Willco9960/Drone_FCU_rev1/Drone_MCU_V1/V1_PLAN.md

# Drone MCU V1: project plan and handoff

Last updated: 2026-11-02. The saved KiCad schematic is the source of truth for the current hardware. Plans and targets below are not verified hardware or performance claims.

## Objective

Build a USB-powered tabletop prototype to develop and evaluate a neural-network flight-stabilization approach. The board reads an IMU, streams timestamped sensor data and MCU model output to a computer, and supports real-time visualization and recording. It must be straightforward to program and debug. V1 has no motor actuation and does not fly.

The long-term goal is a 3-inch-frame autonomous quadcopter that can follow, track and orbit a subject. The intended future aircraft runs stabilization, person detection, selected-subject tracking and follow/orbit decisions onboard. The laptop displays streamed camera video and lets William select a person and request a behavior; it is not intended to compute and send continuous tracking corrections. Automatic obstacle avoidance is out of scope for now. Camera and compute architecture, video and command links, latency, distance/relative-position estimation, target-loss handling, manual override and motor safety are future design work, not implemented capabilities. The preliminary design target is a direct offline laptop link up to 100 m in open conditions using its built-in radio where practical; actual range and requirements must be tested with concurrent camera video and commands, latency, packet loss and link-loss behavior. Prefer an external aircraft antenna rather than a PCB trace antenna and a compact integrated radio/MCU to reduce onboard parts and space. William likes Arduino IDE and libraries; verify real-time performance and exact library support. A Wi-Fi/BLE radio is not automatically compatible with an ExpressLRS receiver or a camera video link.

## Collaboration and project layout

- William builds the schematic and PCB himself as a learning project. Guide him in meaningful groups with clear, readable interactive wiring diagrams. Avoid drawing out the work by asking him to perform one trivial action per round. After each saved group, inspect with KiCad MCP and give precise corrections.
- Do not edit the schematic, PCB or libraries unless he explicitly requests that particular edit. Preserve open-editor/unsaved state. If explicitly editing outside KiCad, start from a fresh saved copy, inspect the entire diff and compare authoritative KiCad-exported pin-level netlists before and after; coordinate editor reload.
- The V1 files are Drone_MCU_V1.kicad_pro, Drone_MCU_V1.kicad_sch (root), MCU.kicad_sch and Sensors.kicad_sch (hierarchical sheets), Drone_MCU_V1.kicad_pcb and Drone_MCU_V1.kicad_dru (custom manufacturing checks). See AGENTS.md here for agent instructions and ../DECISIONS.md for chronological design history. References in the root AGENTS.md describe the earlier F722 project; do not apply them as V1 pin assignments.
- The earlier REV_1/Drone_FCU_rev1.kicad_sch schematic is retained as a historical/reference design. V1 is a fresh design; do not copy unresolved battery, ESC or MCU circuitry without an independent review.
- User prefers LCSC-available and reasonably priced parts and beginner-friendly footprints. Check current price/availability and manufacturer datasheets before selecting components. Use visual diagrams that are readable without overlapping text.

## Current saved state (2026-11-02)

- KiCad 10 root contains MCU and Sensors sheets. U1 is STM32H743VITx in LQFP-100. The PCB now has a provisional 38 x 38 mm rounded outline and four 3.2 mm NPTH mounting holes on a 30.5 x 30.5 mm grid; all 34 electrical footprints have a preliminary top-side placement; there are no traces and no hardware has been tested. The four MCP-created mounting footprints reference a missing library entry and must be repaired before fabrication.
- The saved KiCad-exported netlist connects U1 VDD 11/27/50/75/100, VBAT 6, VDDA 21 and VREF+ 20 to +3V3; VSS 10/26/49/74/99 and VSSA 19 to GND. VCAP 48 and 73 share a net with C10/C11 (2.2 uF each) to GND. ST AN4938 calls for connected VCAP pins and two low-ESR capacitors; actual capacitor ESR, effective capacitance, placement and regulator configuration still need selection and verification.
- J2 USB-C connects both D- contacts via U2 USBLC6 to U1 PA11 and both D+ contacts via U2 to PA12; individual 5.1 kOhm CC resistors, USB_VBUS-powered AP2112K-3.3, and input/output 1 uF capacitors are present. SWD J1 includes target +3V3, SWDIO, SWCLK, grounds 3/5/9 and NRST. BOOT0 has a 10 kOhm pulldown and a button to +3V3; NRST has a switch and 100 nF capacitor to GND. The selected AITRIP SWD probe is not verified and its 3.3 V pins are described as outputs: do not assume they are target-sense inputs or connect competing power sources.
- Sensors sheet uses U5 ICM-42631, with pins 5/8 on +3V3, 2/3/6/7/9 on GND, 10/11 intentionally open, SPI on PA5/PA6/PA7/PB0 and INT1 on PC4. R4 10 kOhm pulls chip select high; C15 100 nF, C16 2.2 uF, C17 10 nF are across the rail. Use single-interface mode and do not configure grounded pin 9 as an output. The placed symbol, footprint and 3D model now use the project-local Drone_MCU_Sensors library; the user-global library remains available. Confirm 3D model alignment in the PCB editor.
- D1 status LED with R5 is active-low on PB1; test pads expose USB_VBUS, +3V3 and GND. Every placed component has an assigned footprint; that is not a finalized BOM. SWD header is 2x5 2.54 mm, logically Cortex-numbered but not physically the standard 1.27 mm Cortex connector.
- The 2026-11-02 cleanup marked 72 unused MCU GPIO pins as no-connect for this bench revision, refreshed the capacitor and ground embedded library symbols, and removed redundant local SWD power labels. Reconnect and remove no-connect flags if any of these GPIOs are used later. KiCad CLI ERC now reports two remaining items: VCAP pins 48/73 power-output conflict (the manufacturer requires their shared connection) and the grounded IMU pin 9 bidirectional warning (use it only as an input). These are not blanket-excluded. Whole-design connected-net membership was compared before and after. The schematic is not yet ready for fabrication or a definitive JLCPCB quote.
- Remaining gates before fabrication: choose and document actual LCSC/JLCPCB part numbers and availability; validate LED polarity, all footprints and supplier assembly capability; verify VCAP and regulator capacitance/ESR including DC bias, current/thermal budget and USB source current; confirm boot option bytes/clock and USB supply for the exact MCU; verify the project-local sensor library and model in PCB/3D view; review the two remaining ERC items and calculate layout/stack-up and mounting constraints. JLCPCB-oriented routing rules assume 2-layer 1 oz FR-4, 1.6 mm thickness and green mask; the chosen order options still need confirmation. A custom rule allows only U5 pad-to-pad clearance of 0.15 mm while keeping the default at 0.20 mm. A separate targeted F.Mask check flags 14 U5 opening gaps around 0.04–0.085 mm against the 0.10 mm criterion: review and repair the footprint mask or obtain explicit assembler confirmation before fabrication. Mounting-hole library links and prior silkscreen violations were repaired on 2026-11-03; verify frame/hardware clearances and unrouted nets. See V1_BOM_REVIEW.md for the candidate BOM and unresolved assembly and power gates. Bench bring-up and USB/DFU/SWD tests have not happened.

## Planned hardware architecture

1. **MCU:** STM32H743VIT6 is the MCU used in V1 and a provisional benchmark for future flight. Its 480 MHz / 2 MB flash / up to 1 MB total RAM gives headroom over the old F722, but a specific neural model plus flight firmware must be benchmarked. William now prefers a smaller, low-cost, non-BGA MCU with integrated wireless and some AI acceleration for a future revision; this supersedes the earlier preference to retain one MCU across revisions, without changing V1. ESP32-S3 is a candidate to benchmark, not an approved replacement. Verify all H743 supply pins, regulator mode, USB supply, VCAP capacitors, BOOT0, reset and clocks for the actual LQFP100 device against the datasheet and ST AN4938. Do not assume same-package F722 pin or power compatibility.
2. **IMU:** ICM-42631 on SPI is the current V1 candidate, replacing the older ICM-42688-P. Verify library portability, pad-mask/stencil fabrication rules, firmware support and assembly sourcing. A 6-axis accelerometer/gyro can estimate roll/pitch under appropriate conditions but cannot provide absolute heading; yaw drifts.
3. **Programming and USB:** accessible SWD (PA13/PA14, target reference, ground and NRST) with an external debugger is the primary programming/recovery path. USB-C supplies the AP2112 3.3 V regulator and carries data for planned bench telemetry. The AITRIP probe and its cable/power behavior remain unverified. USB DFU is an additional target only after exact MCU boot, clock and supply verification and live testing; it is not the sole recovery method.
4. **Expansion:** reserve four motor-control-capable outputs, a receiver interface, and a separate companion/telemetry serial port for later revisions. Select pins by H743 alternate function, timer and DMA analysis. Do not imply DShot or a particular receiver protocol is already validated. Flight hardware and its pinouts are future decisions. User previously selected an AERO SELFIE 45 A 4IN1-ESC-LDO as a candidate; its connector family, mating pin numbering and cable orientation still need physical or reliable primary-source confirmation.
5. **Physical design:** aim for the future 30.5 x 30.5 mm flight-controller mounting pattern, subject to the actual frame and stack clearances. Decide V1 connector locations, board outline, layer count and assembly method before routing. Screen new parts for footprints and availability.

## Neural network, simulator and viewer

- Desktop: RTX 3080 (10 GB dedicated VRAM, 16 GB reported shared memory), i7-12700K, 32 GB RAM, Windows driver reported as 32.0.15.9174. Use as the candidate primary training/simulation machine; PyTorch CUDA is a proposed path, not installed or verified here. The M1 MacBook remains a candidate for programming, telemetry, visualization and lighter experiments.
- Proposed simulation starting point: gym-pybullet-drones + PyTorch, using a conventional PD/PID reference or reinforcement learning and a quadcopter dynamics model. Baseline sensor collection from hand motion tests sensing and noise, but does not establish motor-response dynamics or provide flight-control labels by itself. Vary model mass, inertia, motor dynamics, latency and sensor noise; reserve unseen trajectories/disturbances for evaluation.
- Train models offboard, convert/export using a toolchain confirmed compatible with the actual model and H743, then compare PC vs MCU inference numerically. Record model version, input/output units and coordinate frames, timestamp, CPU time, deadlines, RAM/flash, sample drops and telemetry throughput. User cares about training the stabilization NN, not just a visualization.
- In the viewer, one plane shows estimated measured board orientation. A second must be explicitly labeled a simulated response to the model recommendation, using a stated dynamics model and time horizon; proposed motor corrections are not themselves a physical attitude. Handle yaw drift, timestamps, coordinate frame calibration, disconnects and replay.
- Initial goals (unverified, not guaranteed): IMU sampling and inference 200 Hz, telemetry 100 Hz, viewer 30-60 Hz. Select and benchmark the actual model and adjust targets. Before any flight, validate closed-loop behavior against a conventional baseline and maintain independent arming, motor cutoff and command/link-loss behavior.
- NVIDIA Isaac Sim/Lab may be useful later for synthetic camera scenes. Isaac Sim 6.0.1 published 16 GB VRAM/RTX 4080 minimum; the user's 10 GB 3080 is below that published baseline, and shared memory is not dedicated VRAM. Do not assert that it works or cannot work without testing a specific supported configuration.

## Milestones and acceptance

1. **V1 schematic:** power, MCU, SWD/reset, USB, IMU and intentional expansion are specified and pin-checked. All selected parts and footprints are documented; hierarchy, ERC and pin-level exported netlist reviewed.
2. **V1 PCB:** frame fit, mounting, component clearances, power and return paths, IMU placement, USB routing, decoupling placement and DRC/fabrication outputs reviewed. No unsupported safety claim.
3. **Bench bring-up:** current-limited power procedure, inspect rails, confirm SWD and USB, read sensor identification and samples, check telemetry and behavior on disconnect. No ESC or propellers required.
4. **V1 training/demo:** collect/replay timestamped data, visualize measured orientation and simulated model response, evaluate a held-out simulation set, deploy and compare actual MCU inference, and report latency, sample loss and resource use.
5. **Later flight/autonomy:** separately complete and validate battery/ESC power and protection, receiver, four motors, conventional baseline stabilization, arming/failsafes, then independent simulation and controlled flight testing before adding onboard person detection and selected-subject follow/orbit. Automatic obstacle avoidance is out of scope for now.

## References

- H743 datasheet: https://www.st.com/resource/en/datasheet/stm32h743vi.pdf
- ST hardware design application note: https://www.st.com/resource/en/application_note/an4938-getting-started-with-stm32h74xig-and-stm32h75xig-mcu-hardware-development-stmicroelectronics.pdf
- ICM-42631 datasheet: https://datasheet.lcsc.com/datasheet/pdf/01f1a12efe333b71350ad9221ae6b099.pdf?productCode=C41432121
- JLCPCB manufacturing capabilities: https://jlcpcb.com/capabilities/pcb-capabilities
- STM32Cube.AI: https://stm32ai.st.com/stm32-cube-ai/
- Simulator: https://github.com/learnsyslab/gym-pybullet-drones
- Burman, Quadcopter stabilization with Neural Network (UT Austin, 2016): user-provided PDF is not included in this repository. The report trained a small model to imitate a PD controller; its conclusion states it did not deploy the NN on the microcontroller for flight validation. Do not claim the paper proves NN flight performance.

## Git hygiene

Preserve the user's existing work. Do not stage or commit live *.lck files, .history folders, local *.kicad_prl preferences, or timestamped KiCad backup archives. Never copy credentials into the repo. Keep DECISIONS.md up to date when a meaningful decision changes, including rationale and remaining constraints.

## 2026-11-03 pre-routing cleanup

- Four board-only holes use the standard `MountingHole:MountingHole_3.2mm_M3` footprint. J2 uses the project-local `Drone_MCU_Connectors` library with shell-edge silkscreen moved to fabrication layer; its pads and physical position are unchanged. Some overlapping reference labels were moved from silkscreen to F.Fab.
- KiCad CLI DRC reports 14 IMU mask-clearance violations and 105 unrouted connections; no tracks have been added. The shared-mask-opening experiment was rejected for now: it produced 80 bridge warnings and requires assembler acceptance. Do not waive these or send for manufacture without a reviewed IMU mask/stencil plan. Two schematic ERC warnings remain as described above.
- `V1_BOM_REVIEW.md` records candidate LCSC parts, VCAP and LDO analyses, and unresolved JLC assembly and thermal gates; it is not a validated order BOM.

## 2026-11-03 power and ground routing started

- Added a filled B.Cu GND zone with a notch avoiding the U5 footprint area, and GND vias/traces to C13 and C15. Added selected F.Cu traces: U3 input to C14 and EN, U3 output to C8, U1 pins 20/21, and C1–C4 power-pad chain. These are partial islands: no claim that the regulator output, MCU supplies, VCAP capacitors, USB VBUS, or all ground pads are fully connected.
- After zone refill, KiCad CLI reports 90 unconnected items and the existing 14 U5 mask-spacing violations, with no other DRC findings. Pad/net assignments and footprint identities were unchanged; only power/ground tracks and vias were added. Review decoupling placement, return paths, electrical connectivity, power/thermal budget and IMU assembly plan before fabrication. Further signal routing and refilling can change plane continuity; rerun DRC.

## 2026-11-04 main PCB routing status

The main PCB now enables four copper layers and has electrically complete outer-layer routing with inner GND zones. KiCad after refill reports zero unconnected items, zero schematic-parity issues and the 14 known U5 mask violations. This supersedes the earlier partial-two-layer status. USB coupled routing/90 ohm impedance, actual physical stackup, power widths/current budget, decoupling layout and full assembly review are still unfinished. The board remains on manufacturing hold. See reviews/2026-11-04/REVIEW.md and its final reports.
