Willco9960/Drone_FCU_rev1/Drone_MCU_V1/manufacturing/2026-11-08-quote/BOM_QUOTE_ONLY.csv

Comment | Designator | Footprint | LCSC Part # | MPN
STM32H743VITx | U1 | LQFP-100_14x14mm_P0.5mm | C114409 | STM32H743VIT6
USBLC6-2SC6 | U2 | SOT-23-6 | C7519 | USBLC6-2SC6
AP2112K-3.3 | U3 | SOT-23-5 | C51118 | AP2112K-3.3TRG1
ICM-42631 | U5 | ICM-42631_TDK_LGA14_trial | C41432121 | ICM-42631
100n | C1,C2,C3,C4,C5,C7,C8,C12,C15 | C_0805_2012Metric | C1711 | CL21B104KBCNNNC
4.7u | C6 | C_1206_3216Metric | C2167346 | C1206C475K4RACTU
1u | C9,C13,C14 | C_0805_2012Metric | C116352 | CL21B105KAFNNNE
2.2u | C10,C11 | C_1206_3216Metric | C126604 | GCM31CR71H225KA55L
2.2u | C16 | C_0805_2012Metric | C19110 | CL21B225KAFNNNE
10n | C17 | C_0805_2012Metric | C1710 | CL21B103KBANNNC
10k | R1,R4 | R_0805_2012Metric | C17414 | 0805W8F1002T5E
5k1 | R2,R3 | R_0805_2012Metric | C27834 | 0805W8F5101T5E
1k | R5 | R_0805_2012Metric | C17513 | 0805W8F1001T5E
Status | D1 | LED_0805_2012Metric | C2295 | KT-0805R
USB_C_Receptacle_USB2.0_16P | J2 | USB_C_Receptacle_HRO_TYPE-C-31-M-12 | C165948 | TYPE-C-31-M-12
SW_Push | SW1,SW2 | SW_SPST_B3U-1000P | C231329 | B3U-1000P
SWD | J1 | PinHeader_2x05_P2.54mm_Vertical | C225520 | A2541WV-2x5P
