Willco9960/Drone_FCU_rev1/Drone_MCU_V1/manufacturing/2026-11-08-quote/top_copper.png

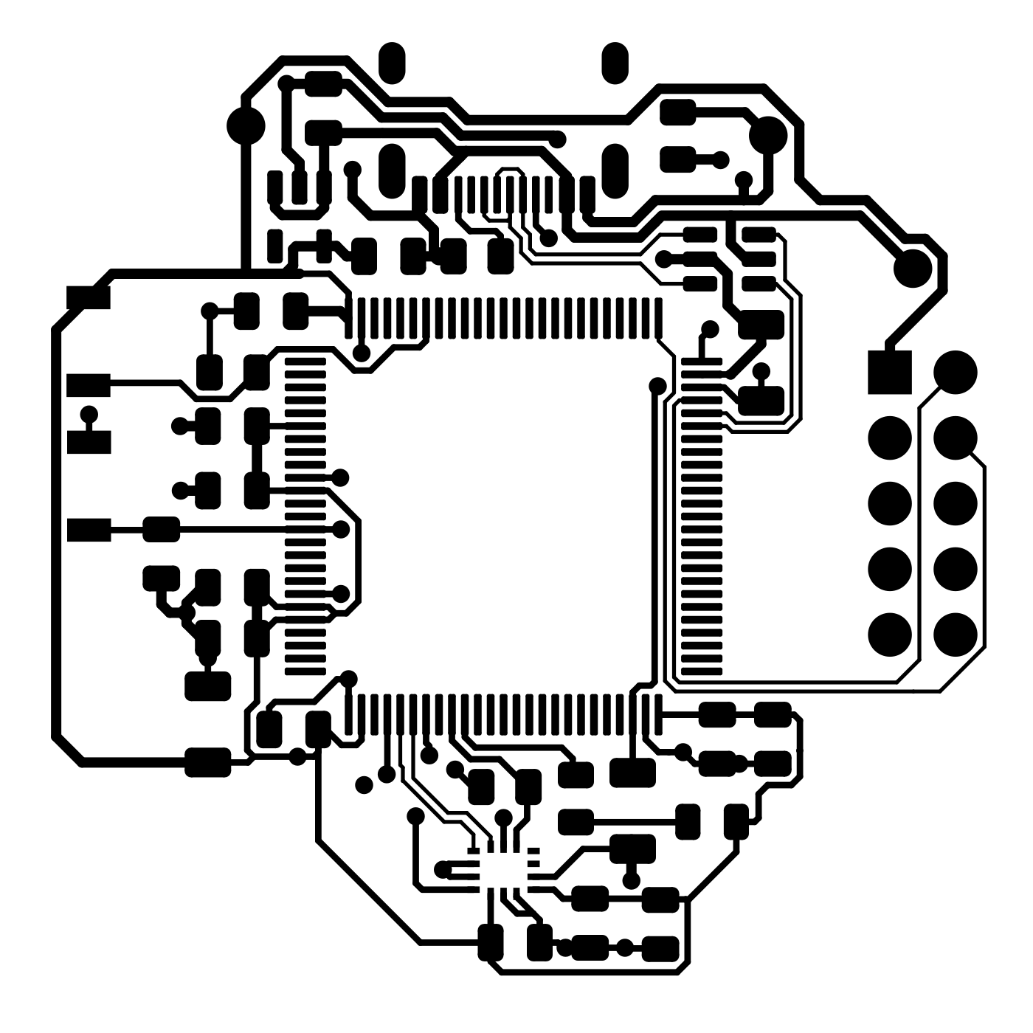
Drone_MCU_V1/manufacturing/2026-11-08-quote/top_copper.png
