Willco9960/Drone_FCU_rev1/Drone_MCU_V1/U5_REPAIR_CHECKLIST.md

# U5 repair and verification checklist

Updated 2026-11-06. V1 is a USB-powered bench prototype, not a flight controller ready to manufacture.

1. [x] Reduce U5 paste clearance by 0.01 mm per side on the placed footprint. A saved-board F.Paste Gerber showed apertures approximately 0.57 by 0.33 mm. Recheck if pad geometry changes; assembler acceptance is outstanding.
2. [ ] Establish and implement a dimensioned land and individual solder-mask design for ICM-42631. The existing pads are 0.59 by 0.35 mm on 0.5 mm pitch; separate mask polygons have insufficient gaps for the assumed 0.10 mm mask web. Manufacturer nominal package contact dimensions are 0.475 by 0.25 mm; these are component contact dimensions, not an independently validated PCB land pattern. Verify placement and assembler process before replacing them.
   - TDK AN-000262 section 2.6 recommends matching the land to the package contact and opening the mask 0.1 mm beyond it. A provisional library footprint named ICM-42631_TDK_LGA14_trial was created with 0.475 x 0.25 mm lands and 0.5 mm pitch, using x=+/-1.1625 and y=+/-0.9125 for the outer pad centers; those centers and pad numbering were checked against the ICM-42631 datasheet package drawing on page 58. The candidate lacks an explicit 0.05 mm mask expansion and final pin-1 marking, and its stencil must be recalculated. It has NOT been applied to the PCB and is NOT fabrication-ready.
   - The project library table now uses relative paths because KIPRJMOD was empty in the editor; KiCad successfully loaded the candidate. A temporary, unsaved board trial with +0.05 mm mask expansion produced 4 DRC errors (all J2 annular width), 23 warnings and 0 reported unconnected items with 2 existing exclusions; 1 schematic parity finding is expected because the schematic retains the original footprint. The trial was reverted to the last saved board. Before application, add a pin-1 indicator, confirm stencil and library settings, then resolve schematic parity and recheck connectivity and Gerbers.
3. [ ] Remove conflicting copper beneath the sensor body as recommended in TDK AN-000393, while maintaining valid ground and signal returns. Define layer-specific keepout, manually reroute affected nets and refill. Verify traces, zones and clearances on every layer. Avoid unnecessary breaks in the USB return plane.
4. [ ] Resolve KiCad DRC and review connectivity. On 2026-11-06, the PCB was updated from the schematic with footprint replacement and field updates disabled, resolving ten USB net-name parity warnings. KiCad GUI DRC after refill reports 0 parity findings and 0 reported unconnected items, with two pre-existing USB-related exclusions; 16 errors and 23 other warnings remain. Full 214-pad comparison found no net changes other than the USB name alignment. Resolve U5 pad clearance, J2 annular ring and other findings against actual manufacturing capabilities. Recheck the two exclusions; inspect mask and paste Gerbers after footprint changes.
5. [ ] Verify 3D model loading/alignment and complete assembly, power, USB, and bench bring-up review before ordering. The project-local ICM-42688-P.step file exists; a footprint dialog showed a missing-model indication, so the actual 3D viewer and project variable resolution still need testing.

Sources: ICM-42631 datasheet DS-000350 rev 1.1, section 10.2, https://datasheet.lcsc.com/datasheet/pdf/01f1a12efe333b71350ad9221ae6b099.pdf?productCode=C41432121 ; TDK AN-000393 rev 1.5, https://invensense.tdk.com/wp-content/uploads/2024/04/AN-000393-TDK-InvenSense-IMU-PCB-Design-and-MEMS-Assembly-Guidelines-v1.5.pdf .

Additional source: TDK AN-000262 rev 1.3, sections 2.5-2.6 and 3.1, https://invensense.tdk.com/wp-content/uploads/2022/07/AN-000262-TDK-IMU-Devices-PCB-Board-Design-Guidelines_v1.3.pdf .

Evidence: the current GUI DRC was run after refill and schematic parity was enabled. The report captured before the USB name alignment is in the Codex workspace as u5-live-drc.rpt; the later result was inspected in the GUI. The MCP DRC wrapper returned a report timestamped earlier than this review and must not be used as current evidence. Earlier backups and trial boards are in the Codex workspace, not fabrication deliverables.

## Update 2026-11-07

- Saved U5 library candidate with 0.475 x 0.25 mm pads, 0.05 mm mask expansion, -0.01 mm paste clearance, SMD type and a pin-1 silk marker. Applied it to the PCB and updated the U5 schematic footprint field. Recheck the marker against nearby via mask and inspect generated mask/paste Gerbers; stencil thickness and assembler approval remain open. The library name intentionally retains the trial suffix.
- GUI DRC after refill and schematic assignment: 4 errors (J2 plated-slot annular width 0.1957 mm vs 0.2000 mm rule), 21 warnings, 0 schematic parity findings and 2 excluded unconnected findings. The two exclusions correspond to the D+ and D- paths through U3 USBLC6-2SC6; the ST functional diagram shows paired I/O pins 1/6 and 3/4. Confirm pad-to-track endpoints and actual BOM part before accepting them. Source: https://www.st.com/resource/en/datasheet/usblc6-2.pdf
- MCP readback from saved board lists 14 U5 pads with the expected nets and new dimensions. Copper under U5, J2 plated slots, 3D path, silkscreen warnings and assembly/bring-up verification remain unfinished. Do not manufacture based on this update.

## U5 Gerber check 2026-11-07

KiCad MCP exported the saved board to the Codex workspace `u5-gerber-check` for inspection; these are review files, not a release package. F.Mask contains 14 U5 flashes, with 0.575 x 0.350 mm rounded-rectangle openings (rotated for the other edge) and 0.150 mm nominal same-row solder-mask webs on the 0.5 mm pitch. F.Paste contains 14 rectangular apertures of 0.455 x 0.230 mm (rotated for the other edge), about 88.1% of the 0.475 x 0.250 mm copper area. The F.Silkscreen Gerber contains the pin-1 circle. No layer geometry was altered during this check.

For a rectangular aperture, area ratio = L*W / (2*(L+W)*stencil thickness): approximately 0.764 at 0.10 mm thickness and 0.637 at 0.12 mm, before fabrication tolerances. Confirm stencil thickness, paste process and aperture acceptance with the assembler. Inspect the mask around the pin-1 mark and adjacent via in a Gerber viewer before release. This does not resolve copper beneath U5, J2 annular width, the other DRC warnings or bring-up review.

## J2 annular ring correction 2026-11-07

J2's four board-instance shield pads were enlarged from 1.00 x 1.60 mm to 1.04 x 1.64 mm for the two short slots, and from 1.00 x 2.10 mm to 1.04 x 2.14 mm for the two long slots. Original centers, GND net and 0.60 x 1.20 / 0.60 x 1.70 mm oblong holes were preserved. GUI DRC after refill reports 0 errors, 22 warnings, 0 schematic parity findings, and 2 excluded USB unconnected findings. MCP saved-board readback confirmed all four pad sizes, centers and GND assignments. The board was already modified in the editor at the start of this work; those existing edits were preserved when saving.

The project library J2 footprint has not yet been updated to match the board instance: the mismatch adds a warning, and updating the board footprint from that library could restore the old undersized rings. Synchronize the library before any footprint update, then recheck DRC. This check does not establish manufacturing readiness; U5 copper, other warnings, Gerbers, BOM, connector fit and electrical/bring-up checks remain open.

## J2 library synchronization 2026-11-07

The project-local J2 library footprint was updated in KiCad to match the four corrected board-instance shield pad sizes, without changing the pad locations or slots. The original library footprint was backed up in the Codex workspace as `J2-original-footprint.kicad_mod`. The subsequent GUI DRC displayed 0 errors and 21 warnings, down from 22 after the J2 footprint mismatch was fixed, plus two excluded USB unconnected findings. The board was saved after the refill. The full remaining warnings, excluded connections, five ignored tests and manufacturing checks still need review.

Correction to the preceding notes: the USBLC6-2SC6 is **U2**, not U3. U3 is the AP2112K-3.3 regulator. Saved-board pad readback assigns U2 pins 1/6 to USB D-, pins 3/4 to USB D+, pin 2 to GND and pin 5 to USB VBUS, consistent with the ST functional diagram. This pad-net check alone does not prove the physical track endpoints or complete USB operation; review the exclusions before release. See https://www.st.com/resource/en/datasheet/usblc6-2.pdf.

Live KiCad IPC trace queries show D- traces ending at U2 pad centers 1 and 6, and D+ traces ending at U2 pad centers 3 and 4. That supports the internal-device explanation for the two excluded findings, but is not an end-to-end USB connectivity or signal-integrity test. The same query confirms GND traces crossing under U5 and an IMU_SCK trace on the back layer passing under part of the sensor; review and manually reroute as appropriate before fabrication. Zone bounding boxes alone do not establish copper fill underneath the package.

Review-only Gerbers for four copper layers, mask, silk, board outline, and separate PTH/NPTH drill files were exported from the saved board to the Codex workspace `v1-fab-review-2026-11-07`. They are not a release package; repeat exports and inspect them after outstanding design changes. Assembly paste files and a validated assembly BOM/placement file have not been prepared.

## IMU trace reroute 2026-11-07

William rerouted the ground escapes and the IMU clock; the saved board now has 413 track segments and 30 vias. Live IPC trace query and visual inspection show the earlier ground traces crossing the U5 body and the former back-layer clock crossing have been removed. Ground escapes now head outward from the five GND pads. This is a trace inspection, not confirmation of copper-zone geometry, via clearance, or end-to-end electrical function. Refilled and saved the board. The DRC screen displayed 0 errors, 21 warnings and 2 existing excluded USB unconnected findings during the run; completion and parity status still require confirmation. Earlier exported review Gerbers predate the reroute and must be regenerated. Check the copper fills on all four layers below U5 before closing item 3.
