Willco9960/Drone_FCU_rev1/Drone_MCU_V1/Drone_MCU_V1.kicad_pcb

## KiCad design Drone_MCU_V1/Drone_MCU_V1.kicad_pcb (2026-11-09)

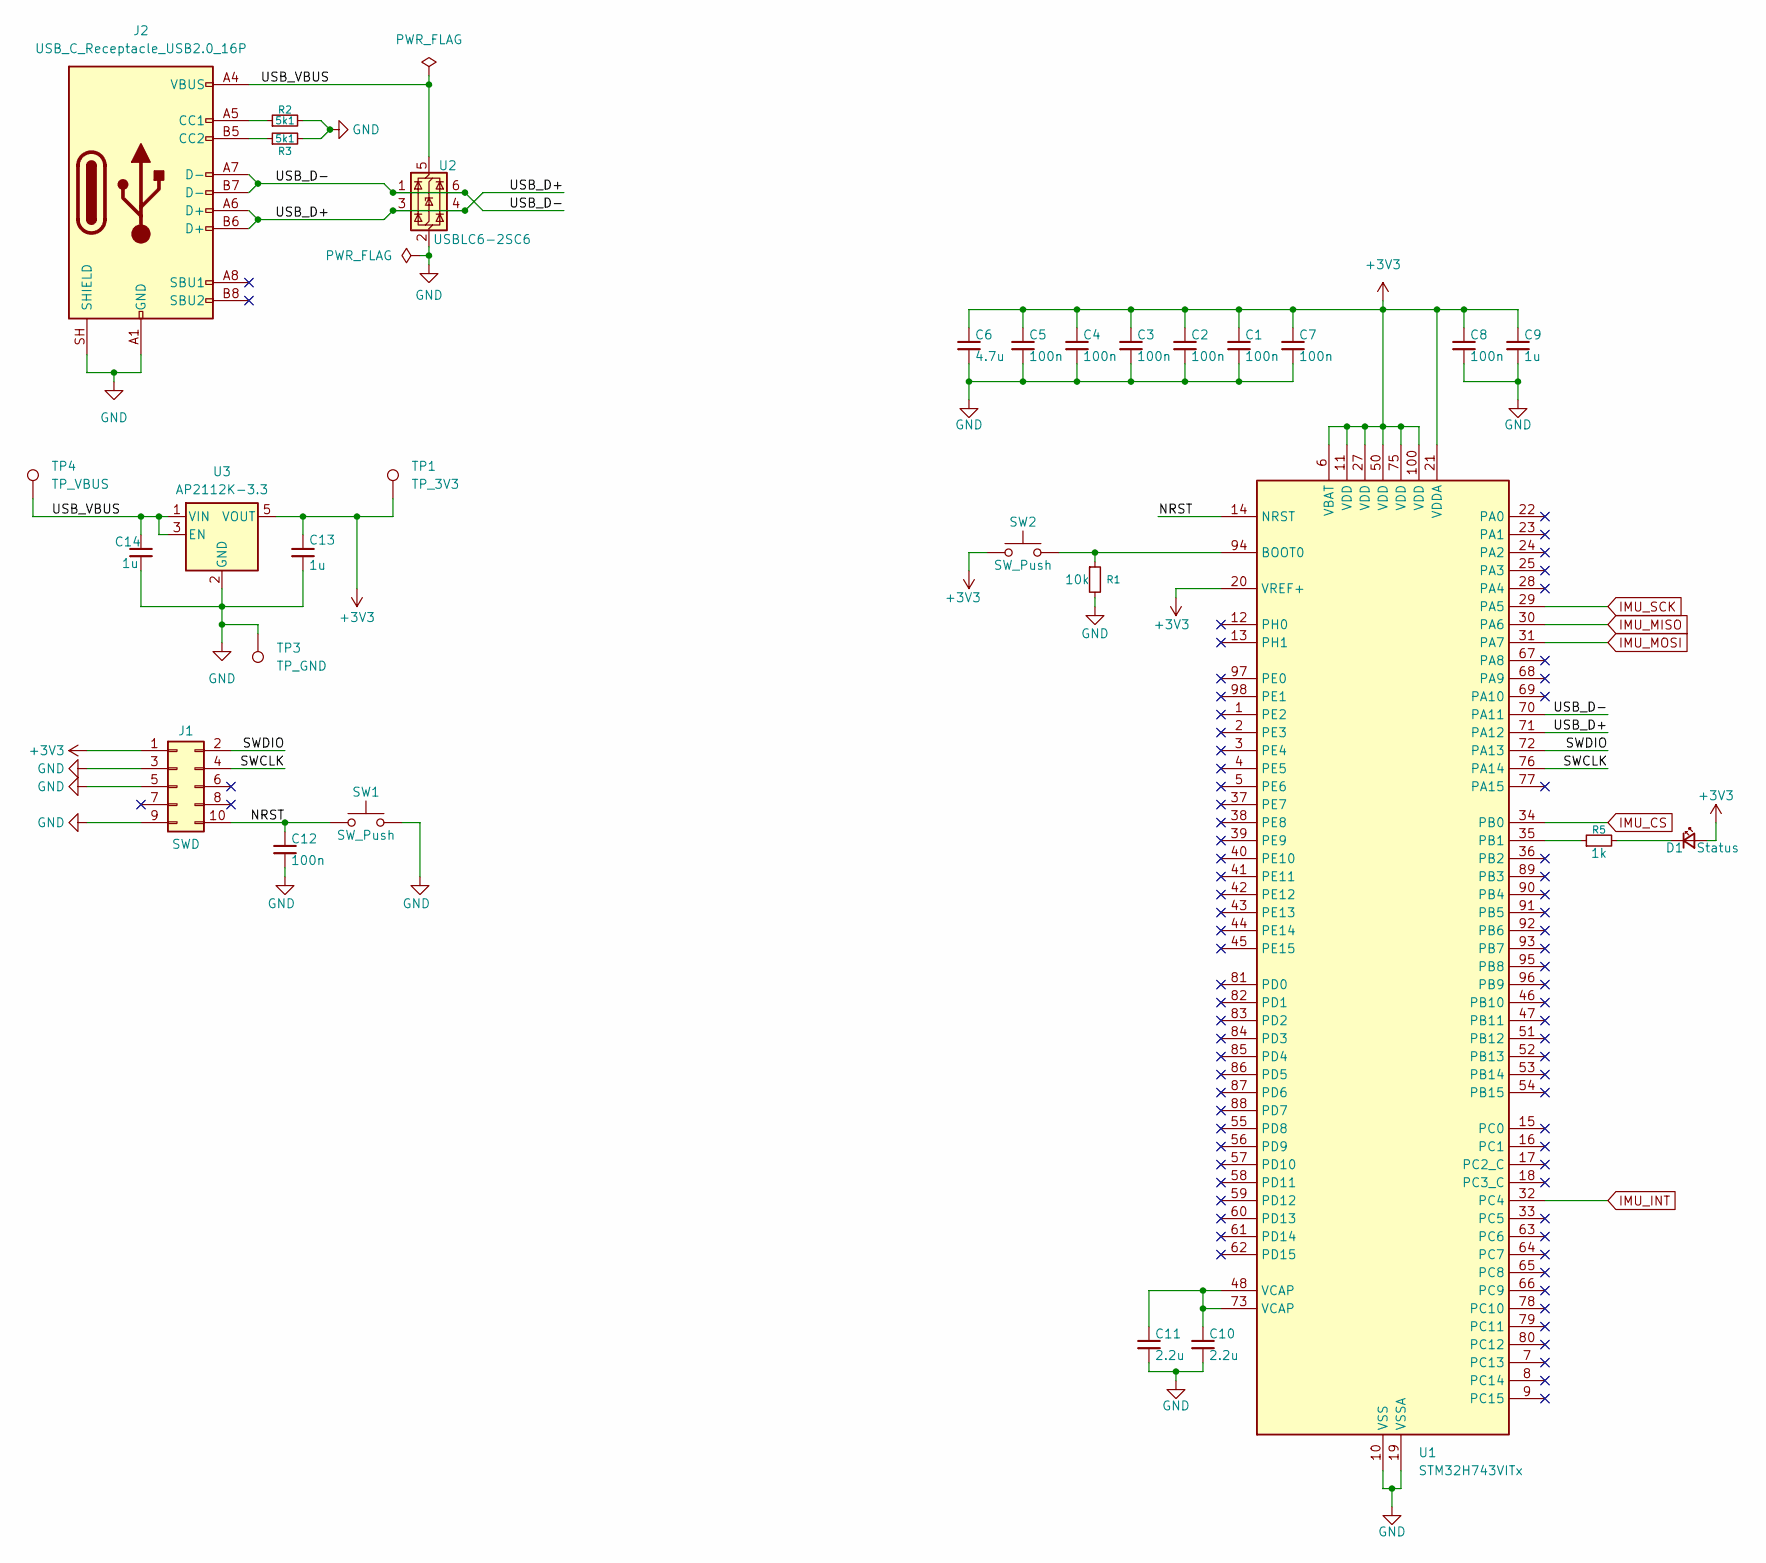
[picture p6: schematic MCU.kicad_sch]

Parts:
C1, C2, C3, C4, C5, C7, C8, C12: 100n; C_0805_2012Metric
C6: 4.7u; C_1206_3216Metric
C9, C13, C14: 1u; C_0805_2012Metric
C10, C11: 2.2u; C_1206_3216Metric
D1: Status; LED_0805_2012Metric
J1: SWD; PinHeader_2x05_P2.54mm_Vertical
J2: USB_C_Receptacle_USB2.0_16P; USB_C_Receptacle_HRO_TYPE-C-31-M-12
R1: 10k; R_0805_2012Metric
R2, R3: 5k1; R_0805_2012Metric
R5: 1k; R_0805_2012Metric
SW1, SW2: SW_Push; SW_SPST_B3U-1000P
TP1: TP_3V3; TestPoint_Pad_D1.5mm
TP3: TP_GND; TestPoint_Pad_D1.5mm
TP4: TP_VBUS; TestPoint_Pad_D1.5mm
U1: STM32H743VITx; LQFP-100_14x14mm_P0.5mm
U2: USBLC6-2SC6; SOT-23-6
U3: AP2112K-3.3; SOT-23-5

Connections:
+3V3: C1.1, C2.1, C3.1, C4.1, C5.1, C6.1, C7.1, C8.1, C9.1, C13.1, D1.2 (A), J1.1, SW2.1, TP1.1 (1_1), U1.6 (VBAT), U1.11 (VDD), U1.20 (VREF+), U1.21 (VDDA), U1.27 (VDD), U1.50 (VDD), U1.75 (VDD), U1.100 (VDD), U3.5 (VOUT); also elsewhere on the board
/MCU/NRST: C12.1, J1.10, SW1.1, U1.14 (NRST)
/MCU/SWCLK: J1.4, U1.76 (PA14)
/MCU/SWDIO: J1.2, U1.72 (PA13)
/MCU/USB_D+: J2.A6 (D+), J2.B6 (D+), U1.71 (PA12), U2.3 (I/O2), U2.4 (I/O2)
/MCU/USB_D-: J2.A7 (D-), J2.B7 (D-), U1.70 (PA11), U2.1 (I/O1), U2.6 (I/O1)
/MCU/USB_VBUS: C14.1, J2.A4 (VBUS), J2.A9 (VBUS), J2.B4 (VBUS), J2.B9 (VBUS), TP4.1 (1_1), U2.5 (VBUS), U3.1 (VIN), U3.3 (EN)
GND: C1.2, C2.2, C3.2, C4.2, C5.2, C6.2, C7.2, C8.2, C9.2, C10.2, C11.2, C12.2, C13.2, C14.2, J1.3, J1.5, J1.9, J2.A1 (GND), J2.A12 (GND), J2.B1 (GND), J2.B12 (GND), J2.SH (SHIELD), R1.2, R2.2, R3.2, SW1.2, TP3.1 (1_1), U1.10 (VSS), U1.19 (VSSA), U1.26 (VSS), U1.49 (VSS), U1.74 (VSS), U1.99 (VSS), U2.2 (GND), U3.2 (GND); also elsewhere on the board
IMU_CS: U1.34 (PB0); also elsewhere on the board
IMU_INT: U1.32 (PC4); also elsewhere on the board
IMU_MISO: U1.30 (PA6); also elsewhere on the board
IMU_MOSI: U1.31 (PA7); also elsewhere on the board
IMU_SCK: U1.29 (PA5); also elsewhere on the board
unnamed: C10.1, C11.1, U1.48 (VCAP), U1.73 (VCAP)
unnamed: D1.1 (K), R5.2
unnamed: J2.A5 (CC1), R2.1
unnamed: J2.B5 (CC2), R3.1
unnamed: R1.1, SW2.2, U1.94 (BOOT0)
unnamed: R5.1, U1.35 (PB1)

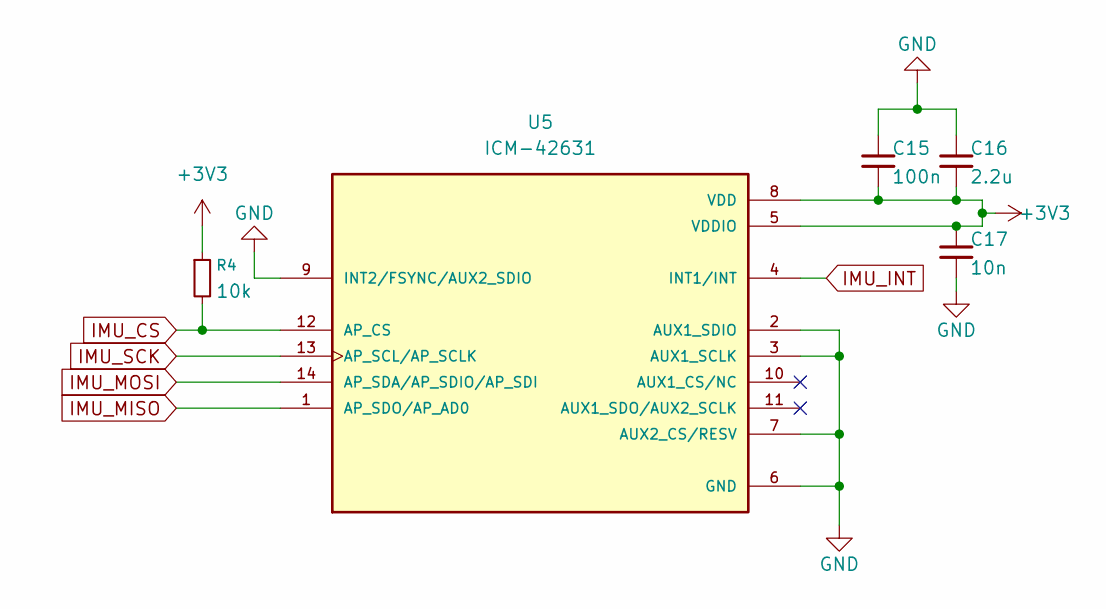
[picture p7: schematic Sensors.kicad_sch]

Parts:
C15: 100n; C_0805_2012Metric
C16: 2.2u; C_0805_2012Metric
C17: 10n; C_0805_2012Metric
R4: 10k; R_0805_2012Metric
U5: ICM-42631; ICM-42631_TDK_LGA14_trial; PARTREV 1.2

Connections:
+3V3: C15.2, C16.2, C17.1, R4.1, U5.5 (VDDIO), U5.8 (VDD); also elsewhere on the board
GND: C15.1, C16.1, C17.2, U5.2 (AUX1_SDIO), U5.3 (AUX1_SCLK), U5.6 (GND), U5.7 (AUX2_CS/RESV), U5.9 (INT2/FSYNC/AUX2_SDIO); also elsewhere on the board
IMU_CS: R4.2, U5.12 (AP_CS); also elsewhere on the board
IMU_INT: U5.4 (INT1/INT); also elsewhere on the board
IMU_MISO: U5.1 (AP_SDO/AP_AD0); also elsewhere on the board
IMU_MOSI: U5.14 (AP_SDA/AP_SDIO/AP_SDI); also elsewhere on the board
IMU_SCK: U5.13 (AP_SCL/AP_SCLK); also elsewhere on the board

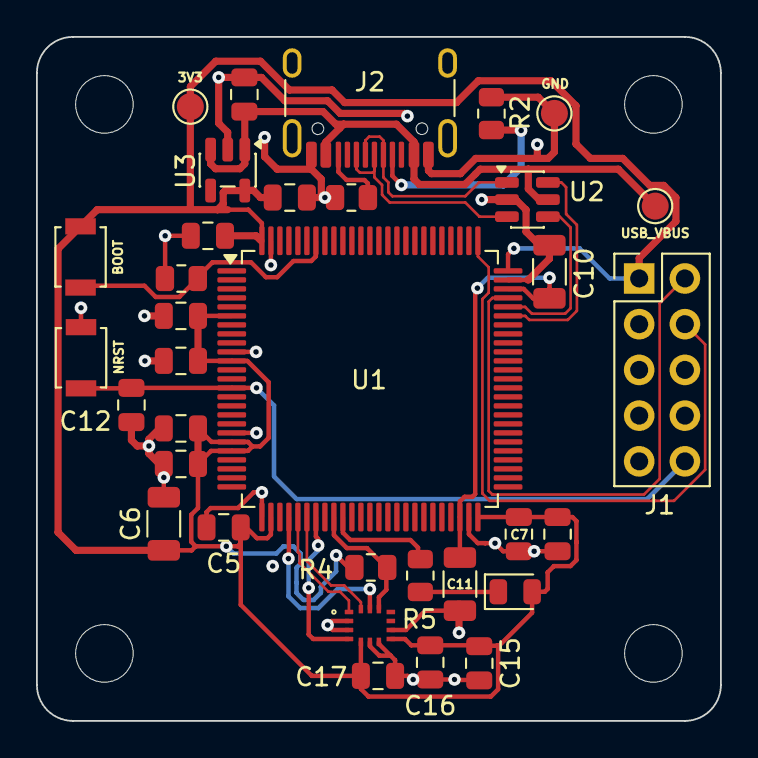
[picture p8: board Drone_MCU_V1.kicad_pcb from above]

Board: 4 copper layers, 38.0 x 38.0 mm, 38 parts (0 on the bottom side), 19 nets.

Other parts of the board:
MH1, MH2, MH3, MH4: MountingHole_3.2mm_M3
