Willco9960/Drone_FCU_rev1/REV_1/Cube_Drone/Cube_Done.ioc

Mcu.UserName=STM32F722VETx
PA11.Signal=USB_OTG_FS_DM
PA12.Signal=USB_OTG_FS_DP
PA13.Signal=SYS_JTMS-SWDIO
PA14.Signal=SYS_JTCK-SWCLK
