Willco9960/Drone_FCU_rev1/(commit log)

2026-02-28 added usb otg and swd
    [Drone_FCU_rev1.kicad_sch]
2026-03-14 Added IMU schematic block
2026-10-28 Update flight controller schematic and libraries
2026-10-31 Add V1 drone MCU prototype and project plan
2026-11-02 Checkpoint V1 schematic and review status
2026-11-02 Checkpoint V1 PCB placement and manufacturing rules
2026-11-06 Record V1 PCB routing and manufacturing review
2026-11-09 Update V1 board and manufacturing review
2026-11-13 Add V1 PCB images to README
